saranshML/solar-panel-monitoring-system/Solar_Panel_Monitoring_Paper.docx

IoT-Based Real-Time Solar Panel Monitoring System Using

ESP32-C3, ADS1115 ADC, ACS758 Current Sensor, and Blynk 2.0 Cloud Platform

Saransh Pandey, Kartik Jeena, Mukul, Shobhit Singh Tomar

Department of Electrical Engineering, College of Technology

G.B. Pant University of Agriculture and Technology, Pantnagar – 263145, Uttarakhand, India

{58857, 58978, 59355, 59369}@gbpuat.ac.in

Supervisor: Dr. Ravi Saxena, Professor, Department of Electrical Engineering, College of Technology| May 2026

Abstract—The rapid global expansion of solar photovoltaic (PV) installations has intensified the need for affordable, accurate, and remotely accessible monitoring systems. Conventional monitoring solutions are either prohibitively expensive for small-scale installations or lack the measurement precision needed to identify localized efficiency losses caused by shading, dust accumulation, and thermal degradation. This paper presents the design, implementation, and field evaluation of a low-cost IoT-based Solar Panel Monitoring System (SPMS V2.0). The system is built around the Seeed Studio XIAO ESP32-C3 microcontroller (32-bit RISC-V, 160 MHz) paired with an ADS1115 16-bit external analog-to-digital converter (ADC) to overcome the nonlinearity and limited resolution of onboard ADC modules. Panel voltage (0–50 V) is measured through a precision resistor voltage divider, load current (0–50 A) is sensed non-invasively using an isolated ACS758 Hall-Effect current transducer with galvanic isolation, and ambient temperature is acquired via a DS18B20 digital probe (−55 °C to +125 °C) over the 1-Wire protocol. Instantaneous power (W), cumulative energy generation (Wh), and estimated financial savings are computed at the edge and displayed locally on an I2C LCD. Simultaneously, all parameters are transmitted to the Blynk 2.0 IoT cloud platform over Wi-Fi, enabling real-time web and mobile dashboard visualization, historical analysis, and fault identification. A custom 3D-printed PLA enclosure provides mechanical protection for field deployment. Field testing confirms low-latency cloud telemetry, stable sensor readings, and reliable operation under practical solar panel conditions, demonstrating that open-source embedded hardware can serve as a viable and scalable monitoring platform for small-to-medium scale PV installations.

Index Terms—Solar photovoltaic monitoring, IoT, ESP32-C3, ADS1115, ACS758, DS18B20, Blynk 2.0, Hall-Effect sensor, real-time telemetry, edge computing, renewable energy.

I. INTRODUCTION

Solar photovoltaic (PV) energy is among the fastest-growing renewable energy technologies worldwide, driven by declining hardware costs, government incentives, and increasing environmental awareness. However, PV systems are highly sensitive to operating conditions: panel efficiency decreases with rising temperature (approximately −0.4 %/°C for crystalline silicon modules), shading and soiling can reduce output by 10–25 %, and load mismatches may cause significant energy losses if left undetected [1]. For both residential users and small commercial operators, these efficiency losses are often invisible without instrumentation.

Traditional monitoring architectures based on Supervisory Control and Data Acquisition (SCADA) systems are reliable but costly, complex, and poorly suited to small-scale, low-output PV installations. The emergence of affordable microcontrollers, wireless connectivity modules, and cloud IoT platforms has enabled a new class of low-cost embedded monitoring systems accessible to researchers, educators, and independent installers [2].

This paper presents a Solar Panel Monitoring System (SPMS V2.0) that bridges this gap. The core contributions are: (1) integration of a high-resolution ADS1115 16-bit external ADC to overcome onboard ADC nonlinearity in ESP32 platforms; (2) use of an ACS758 Hall-Effect current sensor for galvanically isolated current measurement; (3) real-time edge computation of power, cumulative energy, and cost savings; (4) dual-mode monitoring via an I2C LCD display and the Blynk 2.0 cloud platform; and (5) field validation under actual solar panel operating conditions.

A. System Specifications

The system is designed to operate within the following measurement ranges: Voltage: 0–50 V; Current: 0–50 A; Temperature: −55 °C to +125 °C; Communication: IEEE 802.11 b/g/n Wi-Fi (2.4 GHz); Display: 16×2 I2C LCD; Cloud platform: Blynk 2.0.

II. LITERATURE REVIEW

The evolution of PV monitoring has proceeded through three broad phases. The first phase involved SCADA-based industrial monitoring with high accuracy and reliability but prohibitive cost and complexity for small-scale systems. The second phase saw the adoption of Arduino-based embedded systems using onboard ADCs, analog voltage/current sensors (e.g., ACS712), and LM35 temperature sensors. These systems were inexpensive and easy to implement but suffered from poor ADC resolution (10-bit), susceptibility to analog noise, limited wireless range, and lack of cloud integration [2].

The third and current phase is characterized by ESP32-based architectures. The ESP32 family introduced integrated dual-core processing, Wi-Fi/Bluetooth connectivity, improved memory capacity, and lower power consumption relative to ATmega platforms. The ESP32 has become the most widely adopted processing unit in low-cost PV monitoring due to its modularity, integrated wireless communication, and extensive open-source library ecosystem [6].

A key limitation identified in ESP32-based systems is onboard ADC nonlinearity. The internal ADC of most ESP32 variants exhibits significant nonlinearity and calibration inconsistency, especially at mid-range voltages, making it unsuitable for precision measurement [4]. This has driven adoption of the ADS1115 16-bit external ADC, which provides programmable gain amplification (PGA), differential measurement capability, and significantly improved linearity compared to the 12-bit onboard ADC.

For current sensing, Hall-Effect transducers (ACS712, ACS758) have largely replaced shunt resistor methods in low-cost designs because they provide galvanic isolation, eliminating both safety risks and common-mode interference. The ACS758-050B is specifically favoured for high-current measurement (up to 50 A) with a factory-trimmed sensitivity of 40 mV/A [5].

Remote monitoring platforms have also matured significantly. MQTT-based systems, ThingSpeak, Firebase, and Blynk have each been used for cloud telemetry, with Blynk 2.0 emerging as popular for rapid dashboard development due to its virtual pin abstraction, graphical widget library, and free tier for small-scale deployments.

Identified research gaps in prior work include: inadequate calibration and uncertainty analysis; absence of edge-computed financial metrics; limited thermal monitoring capability; single-mode monitoring (local only or cloud only); and lack of enclosure design for field deployment. The proposed system addresses each of these gaps.

III. SYSTEM ARCHITECTURE

The SPMS V2.0 is organized into four functional layers as illustrated in the system block diagram:

The four functional layers are: (1) Sensor Layer — ACS758 current sensor, resistor voltage divider, DS18B20 probe; (2) Signal Conditioning Layer — ADS1115 16-bit ADC and 4.7 kΩ 1-Wire pull-up; (3) Processing and Display Layer — XIAO ESP32-C3 MCU and I2C LCD; (4) Cloud Telemetry Layer — Blynk 2.0 IoT platform, web and mobile dashboards.

A. XIAO ESP32-C3 Microcontroller

The Seeed Studio XIAO ESP32-C3 is an IoT development board featuring the Espressif ESP32-C3 SoC with a 32-bit RISC-V single-core processor operating at up to 160 MHz, 400 KB SRAM, 4 MB on-board flash memory, and an integrated IEEE 802.11 b/g/n Wi-Fi and Bluetooth 5.0 (BLE) subsystem. Its ultra-compact form factor (21 × 17.8 mm) and deep-sleep power consumption of approximately 43 μA make it well suited to low-power IoT monitoring nodes. The board also incorporates hardware security accelerators supporting AES-128/256, RSA, HMAC, and digital signatures, offering a foundation for secure IoT communication.

The ESP32-C3 provides 11 digital GPIO pins (usable as PWM), 4 analog input pins (connected externally to the ADS1115 for improved precision), and hardware support for I2C, SPI, and UART. An onboard battery charge management circuit enables battery-powered operation.

B. ADS1115 16-Bit External ADC

The ADS1115 (Texas Instruments) is an ultra-small, low-power, 16-bit delta-sigma ADC with an I2C interface. It provides a programmable gain amplifier (PGA) with gain settings from ±0.256 V to ±6.144 V full-scale, differential and single-ended measurement modes, and a data rate of up to 860 samples per second. At the default PGA setting of ±6.144 V, the resolution is 0.1875 mV per LSB — approximately 16× finer in step count than the 12-bit ESP32 onboard ADC (65,536 vs. 4,096 steps). The ADS1115 eliminates the nonlinearity and reference voltage inconsistency that limit the ESP32 internal ADC, particularly at mid-range voltages.

C. ACS758 Hall-Effect Current Sensor

The Allegro ACS758-050B is a fully integrated, galvanically isolated Hall-Effect current sensor IC designed for AC and DC current sensing up to ±50 A. The internal copper conductor has a resistance of only 100 μΩ, minimizing power loss. The device is factory-calibrated with a sensitivity of 40 mV/A and a quiescent output voltage (zero-current reference) of V_cc/2 = 2.5 V at a 5 V supply. Galvanic isolation between the current path and signal output eliminates common-mode interference and enhances safety in high-side measurement configurations. The device operates over a 3.0–5.5 V supply range and provides a 120 kHz bandwidth with a 3 μs output rise time.

D. Voltage Divider Network

Panel voltage measurement uses a passive two-resistor voltage divider: R1 = 120 kΩ and R2 = 10 kΩ connected in series across the panel output, with the junction fed to ADS1115 channel A0. The divider scales the panel voltage by a factor of 13:

V_out = V_in × R2 / (R1 + R2) = V_in / 13

To achieve a 0–50 V measurement range, a scaling factor of 12.2 is required. Using R1 = 120 kΩ and R2 = 10 kΩ gives a ratio of (R1+R2)/R2 = 13, yielding V_max = 4.096 × 13 ≈ 53 V, safely covering the 0–50 V design range. High-value resistors (120 kΩ, 10 kΩ) minimize current draw and power dissipation. A 100 nF ceramic capacitor placed at the divider output reduces high-frequency switching noise before the ADC input.

E. DS18B20 Digital Temperature Sensor

The DS18B20 (Maxim/Analog Devices) provides 9–12 bit Celsius temperature measurements over a 1-Wire serial bus, requiring only a single GPIO pin and a 4.7 kΩ pull-up resistor. It achieves ±0.5 °C accuracy over −10 °C to +85 °C and supports up to 64 sensors on the same bus via unique 64-bit serial ROM codes. In this system, the sensor is mounted on the rear surface of the solar panel to monitor module temperature, which directly affects conversion efficiency.

F. I2C LCD Display

A 16×2 character LCD module with I2C backpack (PCF8574 I/O expander) provides local real-time visualization using only two GPIO lines (SDA: GPIO6 (D4), SCL: GPIO7 (D5)). The module is powered at 5 V for optimal backlight brightness. The LiquidCrystal_I2C library is used for communication, displaying voltage, current, power, energy, and temperature in a cyclic refresh loop.

IV. CIRCUIT CONFIGURATION AND SENSOR INTEGRATION

A. Hardware Interconnection

Table I summarizes the complete pin interconnection between the XIAO ESP32-C3 and all peripheral modules. The ACS758 current sensor output is routed through a voltage divider (R3, R4) to ADS1115 channel A1, attenuating the ACS758 output voltage to within the ADC's 0–4 V input range. The DS18B20 data line is pulled high to 3.3 V via R5 = 4.7 kΩ and connected to GPIO5. The system is powered from the solar panel via an XL7015 step-down buck regulator, which provides stable 5 V and 3.3 V supply rails.

Module / Pin | ESP32-C3 Connection
ACS758 V_cc | 5 V rail (XL7015 output)
ACS758 OUT | ADS1115 A1 (via R3/R4 divider)
Voltage Divider V_out | ADS1115 A0 (R1=120 kΩ, R2=10 kΩ)
ADS1115 SDA/SCL | GPIO6 (SDA, D4) / GPIO7 (SCL, D5)
DS18B20 DATA (DQ) | GPIO5 + 4.7 kΩ pull-up to 3.3 V
I2C LCD SDA/SCL | GPIO6 / GPIO7 (shared I2C bus)
XL7015 Input | Solar panel positive terminal

TABLE I: Pin Interconnection Mapping

B. Voltage Measurement

The actual panel voltage is reconstructed from the raw ADS1115 reading using:

V_in = ADC_count × (0.1875 mV/LSB) × [(R1 + R2) / R2] [R1=120 kΩ, R2=10 kΩ]

V_in = ADC_count × 0.0001875 × 13 = ADC_count × 0.0024375 V

Precision 1% tolerance resistors are used to minimize scaling error. A calibration factor derived experimentally during commissioning further reduces residual offset.

C. Current Measurement

The load current is derived from the ACS758 output voltage measured at ADS1115 channel A1. Using the sensor's datasheet parameters:

I (A) = (V_sensor − V_offset) / S_i

where V_offset = 2.50 V (quiescent output at zero current) and S_i = 40 mV/A (factory sensitivity for ACS758-050B). V_sensor is obtained from the ADC count adjusted for the R3/R4 voltage divider ratio. Because the offset voltage is sensitive to supply voltage variation, an empirical calibration step measures and stores V_offset at zero-current conditions during system startup.

D. Power, Energy, and Cost Computation

Instantaneous power is computed as P (W) = V_in × I_actual. Cumulative energy is numerically integrated over time:

E (Wh) = Σ [P × Δt / 3,600,000]

where Δt is the sampling interval in milliseconds. Estimated financial savings are computed as:

Savings (INR) = (E / 1000) × T_rate

where T_rate = ₹6.50/kWh (average Indian residential electricity tariff). These computed values are displayed on the LCD and transmitted to Blynk virtual pins.

V. SOFTWARE IMPLEMENTATION

A. Firmware Architecture

The firmware is developed in Embedded C/C++ using the Arduino IDE (v2.x) with ESP32 board support (espressif/arduino-esp32). The main execution loop runs every 2 seconds in the following sequence:

1. Read ADS1115 channels A0 (voltage divider) and A1 (ACS758 output).

2. Compute V_in, I_actual, instantaneous power P, and energy increment ΔE.

3. Request DS18B20 temperature conversion and read result.

4. Update cumulative energy (Wh) and estimated financial savings (INR).

5. Refresh the I2C LCD display with current parameter values.

6. Push all six values to Blynk cloud via Blynk.virtualWrite(Vn, value).

The following external libraries are required: Adafruit_ADS1X15 (ADS1115 driver), DallasTemperature and OneWire (DS18B20 driver), LiquidCrystal_I2C (LCD driver), and Blynk (cloud telemetry). Wi-Fi credentials and the Blynk authentication token are stored as firmware constants.

B. Blynk 2.0 Cloud Configuration

A Blynk template is created on blynk.cloud for the hardware type ESP32 with Wi-Fi connectivity. Six virtual datastreams are configured, as summarized in Table II. The web dashboard uses gauge and chart widgets for trend visualization; the mobile dashboard mirrors these with additional label widgets for numerical readouts. The ESP32-C3 authenticates with the Blynk cloud using a device-specific authentication token and continuously pushes updated values within the main firmware loop using Blynk.virtualWrite(Vn, value).

Virtual Pin | Parameter | Unit / Widget
V0 | Panel Voltage | V — Gauge
V1 | Load Current | A — Gauge
V2 | Instantaneous Power | W — Chart
V3 | Cumulative Energy | Wh — Label
V4 | Panel Temperature | °C — Gauge
V5 | Estimated Savings | ₹ — Label

TABLE II: Blynk 2.0 Virtual Pin Datastream Mapping

VI. ENCLOSURE DESIGN

A custom two-part protective enclosure was designed in Autodesk Tinkercad and fabricated via Fused Deposition Modelling (FDM) with the following parameters: material — 1.75 mm PLA thermoplastic; layer height — 0.20 mm; infill density — 20%; extruder temperature — 205 °C; bed temperature — 60 °C; total print time — approximately 8 hours (6 h main body + 2 h lid).

The main body provides a hollow internal cavity with uniform wall thickness, a flat base for stable placement, and vertical side walls to simplify fabrication. The detachable lid features an overlapping edge profile for alignment and fitment, with a cutout for the LCD display on the upper face. The DS18B20 sensor is mounted externally on the rear of the solar panel using high-conductivity thermal adhesive. Screw terminals for solar panel input and load output are accessible on the enclosure side walls.

VII. RESULTS AND DISCUSSION

A. Measurement Performance

Under laboratory and field conditions, the voltage measurement chain (100 kΩ / 10 kΩ divider + ADS1115) produced readings with a maximum absolute error of approximately ±0.22 V over the 0–50 V range when using 1% tolerance resistors, compared to errors exceeding ±1.5 V observed when using the onboard ESP32 ADC without external calibration. The improvement is attributable to the 16-bit resolution (0.1875 mV/LSB) and superior linearity of the ADS1115.

Current measurements using the ACS758-050B were stable within ±0.15 A after empirical offset calibration at zero-current conditions. At very low currents (< 0.5 A), fluctuations of ±0.08 A were observed, consistent with Hall-Effect sensor behaviour near the noise floor. Temperature readings from the DS18B20 were consistent with a calibrated reference thermometer to within ±0.5 °C, matching the sensor's specified accuracy. Table III summarizes the measured error budget for each sensing channel.

Parameter | Error Source | Max Error
Voltage | Resistor tolerance, ADC quantization | ±0.22 V
Current (> 0.5 A) | Offset drift, sensitivity variation | ±0.15 A
Current (< 0.5 A) | Hall-Effect noise floor | ±0.08 A
Temperature | DS18B20 inherent accuracy | ±0.5 °C
Cloud Latency | Wi-Fi + Blynk server round-trip | < 500 ms

TABLE III: Measurement Error Budget

B. Cloud Telemetry Performance

The Blynk 2.0 dashboard successfully visualized all six parameter streams on both web and mobile interfaces. Under stable Wi-Fi conditions, the round-trip latency between the ESP32-C3 hardware node and the Blynk cloud dashboard was measured at under 500 ms. The LCD continued updating normally during brief Wi-Fi dropouts, confirming that local monitoring is not dependent on cloud connectivity.

Historical data recorded by Blynk's server-side storage enabled post-session energy trend analysis. Over a 4-hour field test under partial cloud conditions, the system recorded cumulative energy generation of approximately 56 Wh and estimated financial savings of ₹0.36 from a 20 W test panel — approximately 70% of the theoretical 80 Wh maximum — consistent with the partial cloud irradiance conditions observed during testing.

C. Discussion

The results confirm that the integration of an external 16-bit ADC significantly improves measurement precision compared to onboard ADC-based implementations commonly reported in prior literature. The use of the ACS758 Hall-Effect sensor provides a safe, non-invasive current measurement solution with performance adequate for small-scale PV applications. The dual-mode operation (local LCD + cloud dashboard) improves system resilience relative to cloud-only designs.

Observed limitations include: (1) current measurement noise below 0.5 A reduces accuracy at low irradiance conditions; (2) cloud monitoring requires stable Wi-Fi connectivity; (3) the enclosure is not rated to IP65 or higher, limiting long-term outdoor deployment without modification; (4) the system does not include reverse polarity protection; and (5) no offline data logging capability exists in the current implementation.

D. Future Improvements

Planned enhancements include: integration of an SD card module for offline energy logging; GSM or LoRa wireless modules for connectivity in remote areas without Wi-Fi; an irradiance sensor (photodiode or pyranometer) to compute panel efficiency; MPPT integration for active power optimization; machine learning-based fault detection models trained on historical Blynk data; and an IP65-rated waterproof enclosure for permanent outdoor installation.

VIII. CONCLUSION

This paper presented the design, implementation, and field evaluation of an IoT-based Solar Panel Monitoring System (SPMS V2.0) using the Seeed Studio XIAO ESP32-C3, ADS1115 16-bit ADC, ACS758 Hall-Effect current sensor, DS18B20 digital temperature probe, I2C LCD display, and Blynk 2.0 cloud platform. The system successfully demonstrated real-time, dual-mode monitoring of photovoltaic voltage, current, power, cumulative energy, temperature, and estimated financial savings under practical operating conditions.

Key contributions of this work are: (a) use of a high-resolution external ADC to address ESP32 onboard ADC nonlinearity; (b) galvanically isolated current sensing up to 50 A; (c) edge-computed financial savings metric for direct user value; (d) field-validated cloud telemetry with sub-500 ms latency; and (e) a compact 3D-printed enclosure for real-world deployment. The system provides an accessible, scalable, and cost-effective solution for small-to-medium scale solar PV monitoring in residential, agricultural, and educational settings.

COMPARATIVE ANALYSIS

Table IV compares the proposed SPMS V2.0 against representative prior works across key hardware, sensing, communication, and cost dimensions. The proposed system is the only implementation combining a 16-bit external ADC, galvanically isolated high-current sensing (0–50 A), digital temperature measurement, and bidirectional cloud telemetry within a low-cost, open-source platform.

Feature | This Work (SPMS V2.0) | Patil et al. [2] | Arduino+ACS712 | ESP32+ThingSpeak | SCADA
MCU | ESP32-C3 (RISC-V) | Arduino Uno | Arduino Mega | ESP32 Classic | Industrial PLC
ADC | ADS1115, 16-bit ext. | ATmega 10-bit | ATmega 10-bit | ESP32 12-bit | Industrial ADC
Current Sensor | ACS758, galv. isolated | ACS712, no isolation | ACS712 | ACS712 | CT/Shunt
Temp. Sensor | DS18B20, digital | LM35, analog | LM35, analog | DHT22 | RTD/PT100
Cloud Platform | Blynk 2.0 (Wi-Fi) | None / Local only | None | ThingSpeak | SCADA Server
V Range | 0–50 V | 0–25 V | 0–30 V | 0–30 V | Any
I Range | 0–50 A | 0–20 A | 0–20 A | 0–30 A | Any
Cost (approx.) | ~₹1,500 | ~₹800 | ~₹600 | ~₹900 | >₹50,000

TABLE IV: Comparison with Prior PV Monitoring Systems

ACKNOWLEDGMENT

The authors thank Dr. Ravi Saxena (Project Guide, Professor, EED) for expert mentorship and Mr. Ajay Kumar (Foreman, EED) for equipment support. Gratitude is also extended to Dr. Ajay Srivastava (HoD, EED) and all faculty members of the Department of Electrical Engineering, College of Technology, GBPUAT Pantnagar, for providing infrastructure and institutional support.

REFERENCES

[1] A. Mellit and S. A. Kalogirou, 'Fault detection and diagnosis methods for photovoltaic systems: A review,' Renewable and Sustainable Energy Reviews, vol. 91, pp. 1–17, Aug. 2018.

[2] R. Patil et al., 'IoT-based solar panel monitoring framework using Arduino Uno and wireless communication,' in Proc. Int. Conf. on Intelligent Computing and Control Systems (ICICCS), Madurai, India, 2019, pp. 343–347.

[3] M. A. Obi and R. Bass, 'Trends and challenges of grid-connected photovoltaic systems — A review,' Renewable and Sustainable Energy Reviews, vol. 58, pp. 1082–1094, May 2016.

[4] Texas Instruments, ADS1115: Ultra-Small, Low-Power, 16-Bit Analog-to-Digital Converter with Internal Reference, Datasheet SBAS444D, Texas Instruments, Austin, TX, 2015.

[5] Allegro MicroSystems, ACS758xCB: Fully Integrated, Galvanically Isolated Hall-Effect-Based Linear Current Sensor IC, Datasheet ACS758-DS, Allegro MicroSystems, Manchester, NH, 2018.

[6] Espressif Systems, ESP32-C3 Series SoC Technical Reference Manual, Rev. 1.2, Espressif Systems, Shanghai, China, 2023. [Online]. Available: https://docs.espressif.com/projects/esp-idf/en/latest/esp32c3/

[7] Seeed Studio, 'Getting Started with Seeed Studio XIAO ESP32C3,' Seeed Studio Wiki, 2023. [Online]. Available: https://wiki.seeedstudio.com/XIAO_ESP32C3_Getting_Started/

[8] Analog Devices / Maxim Integrated, DS18B20 Programmable Resolution 1-Wire Digital Thermometer, Datasheet, Analog Devices, Wilmington, MA, 2019.

[9] Blynk Inc., 'Blynk 2.0 Documentation,' Blynk, 2023. [Online]. Available: https://docs.blynk.io/
