saranshML/solar-panel-monitoring-system/(commit log)

2026-05-31 Add solar panel monitoring system code
    Initial implementation of solar panel monitoring system using ESP32-C3, ADS1115, ACS758, DS18B20, and LCD.
2026-09-08 Update README.md by removing architecture diagrams
    Removed sections for System Architecture and Circuit Diagram.
